pfkellogg/fm1-sustain-footswitch/schematics/fm1_footswitch_layout.pdf

## FM-1 Sustain Footswitch — Layout / Assembly Diagram

Top-down view of enclosure: pedal jack + built-in button (left panel), Arduino Uno (center), MIDI out jack (right panel), pitch strip (front panel)

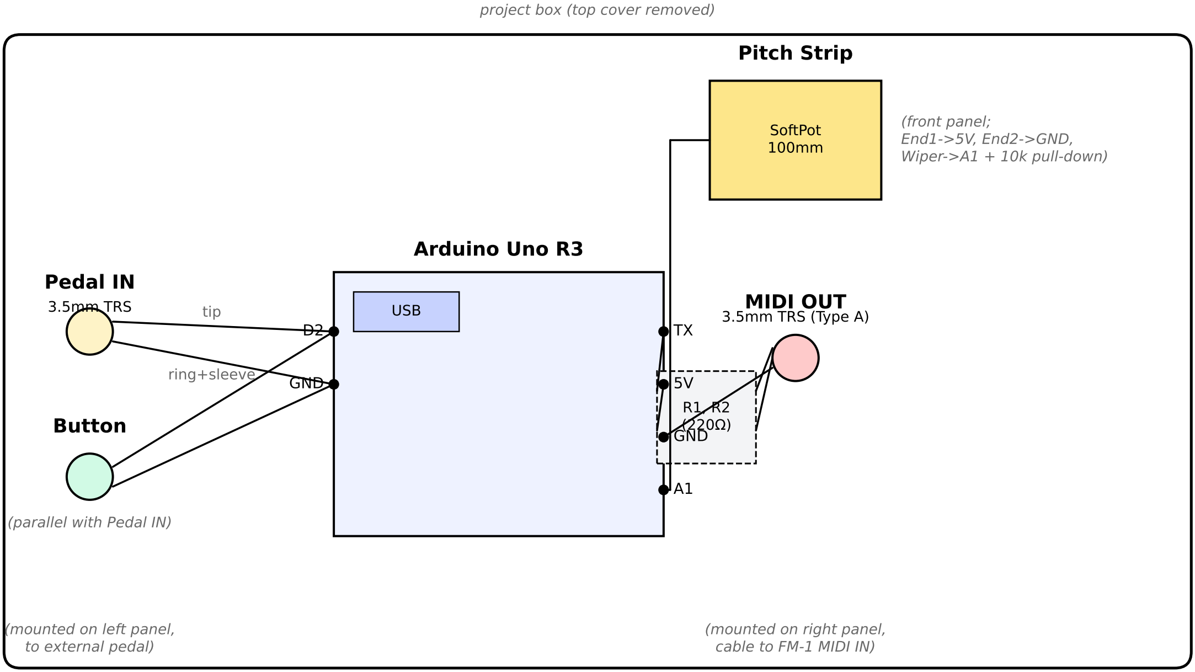
[picture p3: figure]
project box (top cover removed); Arduino Uno R3; USB; GND; Pedal IN; 3.5mm TRS; (mounted on left panel, to external pedal); Button; (parallel with Pedal IN); MIDI OUT 3.5mm TRS (Type A); (mounted on right panel, cable to FM-1 MIDI IN); tip; ring+sleeve; Pitch Strip; SoftPot 100mm; (front panel; End1->5V, End2->GND, Wiper->A1 + 10k pull-down)

Notes:
- Resistors R1/R2 can live on a small offcut of perfboard, or be soldered directly in-line on the wire runs -- exact placement isn't critical
- See the schematic for the electrical connections (which wire goes through which resistor) -- this diagram is for physical placement only
- Button and Pedal IN jack are wired in parallel to the same D2/GND nodes -- either one alone triggers sustain, so the pedal can be left unplugged
- Leave slack on the USB cable path -- the board still needs to be reachable for re-flashing (disconnect MIDI OUT jack's TX lead first)
- Pitch Strip needs 3 wires to the Uno area (End1->5V, End2->GND, Wiper->A1) plus R3 (10k pull-down, A1->GND) -- shown bundled here for clarity
- OLED display, mode switch, and audio-input pitch detector removed -- the OLED moved permanently to a separate project, fm1-midi-voice-tuner
