pfkellogg/fm1-sustain-footswitch/(commit log)

2026-08-03 Add FM-1 sustain footswitch: Arduino sketch, schematic, and layout diagram
    Confirmed working end-to-end: TRS pedal -> Arduino Uno -> CC64 over
    direct-wired TRS MIDI (Type A) -> FM-1 sustain.
2026-08-04 Add built-in panel button option (parallel with pedal jack)
    Lets sustain work with no external pedal plugged in -- the button
    wires to the same D2/GND nodes as the pedal jack, so no new pin or
    code path is needed. Updates the schematic/layout diagrams, README,
    and the sketch's header comment accordingly.
2026-08-05 Add OLED sustain status display
    Shows SUSTAIN ON/OFF on a 0.96" I2C SSD1306, updated on every debounced
    pedal/button transition. Confirmed working on hardware.
2026-08-05 Add OLED mode switch: Sustain status or Pitch detection
    New SPDT switch on D3 selects what the OLED shows. Sustain mode is
    unchanged. Pitch mode reads the FM-1's headphone output through a bias/
    coupling circuit into A0 and runs autocorrelation-based pitch detection
    (240-sample buffer, parabolic interpolation), showing note, octave,
    frequency (1 decimal), and cents offset. Untested against a real FM-1
    signal -- noise-floor and confidence thresholds are starting points.
    [fm1_sustain_footswitch.ino]
2026-08-05 Add mode switch, OLED, and pitch-audio circuit to schematic + layout
    Extends the schematic generator to cover the new hardware from the last
    commit: mode switch on D3, OLED I2C wiring, and the bias/coupling circuit
    (R3/R4/R5/C1) feeding A0 from the FM-1 headphone output. Regenerated both
    diagrams (PDF/PNG/SVG).
2026-08-09 Remove OLED, mode switch, and audio-input pitch detector
    The OLED note/frequency display moved to a new standalone project
    (fm1-midi-voice-tuner) instead of living here. This board goes back
    to just: pedal/button -> CC64 sustain, plus the softpot pitch strip.
2026-08-09 Remove joystick from schematics; fix stale comments
    Schematics still showed the abandoned 2-axis joystick design even
    though the sketch was replaced with a single-axis softpot pitch strip
    weeks ago. Swapped the Joystick block for a Pitch Strip block (Wiper
    -> A1 through a 10k pull-down, End1/End2 -> 5V/GND) in both the
    schematic and layout diagrams, and dropped the now-unused D4/A2 pins
    from the Arduino block. Also corrected two stale header comments: the
    joystick-vs-strip history note, and "OLED coming back later" (it
    moved permanently to fm1-midi-voice-tuner instead).
    [fm1_sustain_footswitch.ino]
2026-08-09 Rewrite README to match current hardware; mark pitch strip on hold
    The README still described the OLED, mode switch, and audio-input
    pitch detector as current optional features, even though all three
    were removed from the sketch in the last two commits. Rewrote it to
    match reality: pedal/button -> CC64 sustain, plus the softpot pitch
    strip (documented, but on hold pending sourcing the part -- the
    originally-planned SparkFun SKU is discontinued, and it was never
    actually available on Amazon; Adafruit #178 is the current known
    source).
